Nitrokey/nitrokey-3a-nfc-lpc55-hardware/README.md

# Nitrokey 3A NFC Hardware

The hardware files of [Nitrokey 3A NFC](https://shop.nitrokey.com/shop/nk3an-nitrokey-3a-nfc-147).
The firmware is [here](https://github.com/Nitrokey/nitrokey-3-firmware).
