Nitrokey/nitrokey-3a-nfc-lpc55-hardware/production-data/nk3an133-gaia-BOM.xlsx

BOM Version 3 | NK3AN133 – Gaia | 2026-04-23
Component | Description | Part | References | Value | Footprint | Quantity Per PCB | MPN | Manufacturer | Alternative | URL
1 | C0G cap, pref 2%, max 5% | C | C20 C21 CY1 | 8pF | C_0402_1005Metric | 3
2 | C0G cap | C | C16 | 47pF | C_0402_1005Metric | 1
3 | X5R or X7R, 10V | C | C2 C14 C15 | 100n | C_0402_1005Metric | 3
4 | X5R 10V | C | C1 C3 C4 | 22u | C_0603_1608Metric | 3 | C1608X5R1A226M080AC | TDK Corporation
5 | X5R or X7R, 10V | C | C13 C17 | 10uF | C_0402_1005Metric | 2 |  |  | Taiyo Yuden LDK105CBJ106MVLF
6 | C0G cap, pref. 2%, max 5% | C | CX1 | 100pF | C_0402_1005Metric | 1
7 | C0G cap | C | C5 | 20pF | C_0402_1005Metric | 1
8 | Resistor 1% | R | R2 | 1k | R_0402_1005Metric | 1
9 | TVS Diode | tvs diode | D2 | TPD4S012DRYR | UFDFN-6_1.45x1mm | 1 | TPD4S012DRYR | Texas Instruments
10 | SPI flash IC | spi flash | F1 | GD25Q16EEIGR | FLASH_2x3_USON8 | 1 | GD25Q16EEIGR | GigaDevice Semiconductor (HK) Limited
11 | FPC connector 1x4 0.5mm | fpc conn | J2 | Conn_01x04 | FPC_4_0.5-THD0509-04CL-GF | 1 | THD0509-04CL-GF | THD |  | https://www.lcsc.com/product-detail/C283133.html
12 | Inductor | L | L2 | 4u7H | L_0603_1608Metric | 1 | MLF1608A4R7KTA00 | TDK Corporation
13 | RGB LED, red/green/blue/anode | LED_RGBA | L1 | LED_RGBA | RGB_LED_606 | 1 | 150066M153000 | Würth
14 | NFC power harvesting IC | FM11NC08 | N1 | FM11NC08 | MLPD3X3 | 1 | FM11NC08 | Shanghai Fudan Microelectronics Group
15 | USB-A male plug | USB_A_Plug | J1 | USB_A_Plug | USB-A-PLUG | 1 | 480372200 | Molex
16 | Resistor 1% | R | R1 | 180R | R_0402_1005Metric | 1
17 | Resistor 1% | R | R3 R4 R6 | 4.7k | R_0402_1005Metric | 3
18 | 3.3V LDO | TLV742p | T1 | TLV742p | Texas_X2SON-4_1x1mm_P0.65mm | 1 | TLV74233PDQNR | Texas Instruments | Diodes AP7340-33FS4-7
19 | LPC55 microcontroller | LPC55S69JEV98K | U1 | LPC55S69JEV98K | BGA98C50P13X13_700X700X97N | 1 | LPC55S69JEV98K | NXP USA Inc.
20 | Proximity sensor | TTP233D-HA6 | U2 | TTP233 | SOT-23-6 | 1 | TTP233D-HA6 | Tontek Design Tech
21 | Secure element | SE050 | U3 | SE050 | UQFN-20-1EP_3x3mm_P0.4mm_EP1.85x1.85mm | 1 | SE050C1HQ1/Z01SCZ | NXP | SE050C2HQ1/Z01SCZ
22 | Two pin crystal | Crystal | Y1 | XRCGB16M000FXN01R0 | Crystal-2mmx1.6mm | 1 | XRCGB16M000FXN01R0 | Murata
23 | Bidirectional transient-voltage-suppression diode | D_TVS | Z1 | GG040205100N2P | D_0402_1005Metric | 1 | GG040205100N2P | AVX Corporation
