Nitrokey/nitrokey-3a-nfc-lpc55-hardware/NK3AN-lpc55-v1.pdf

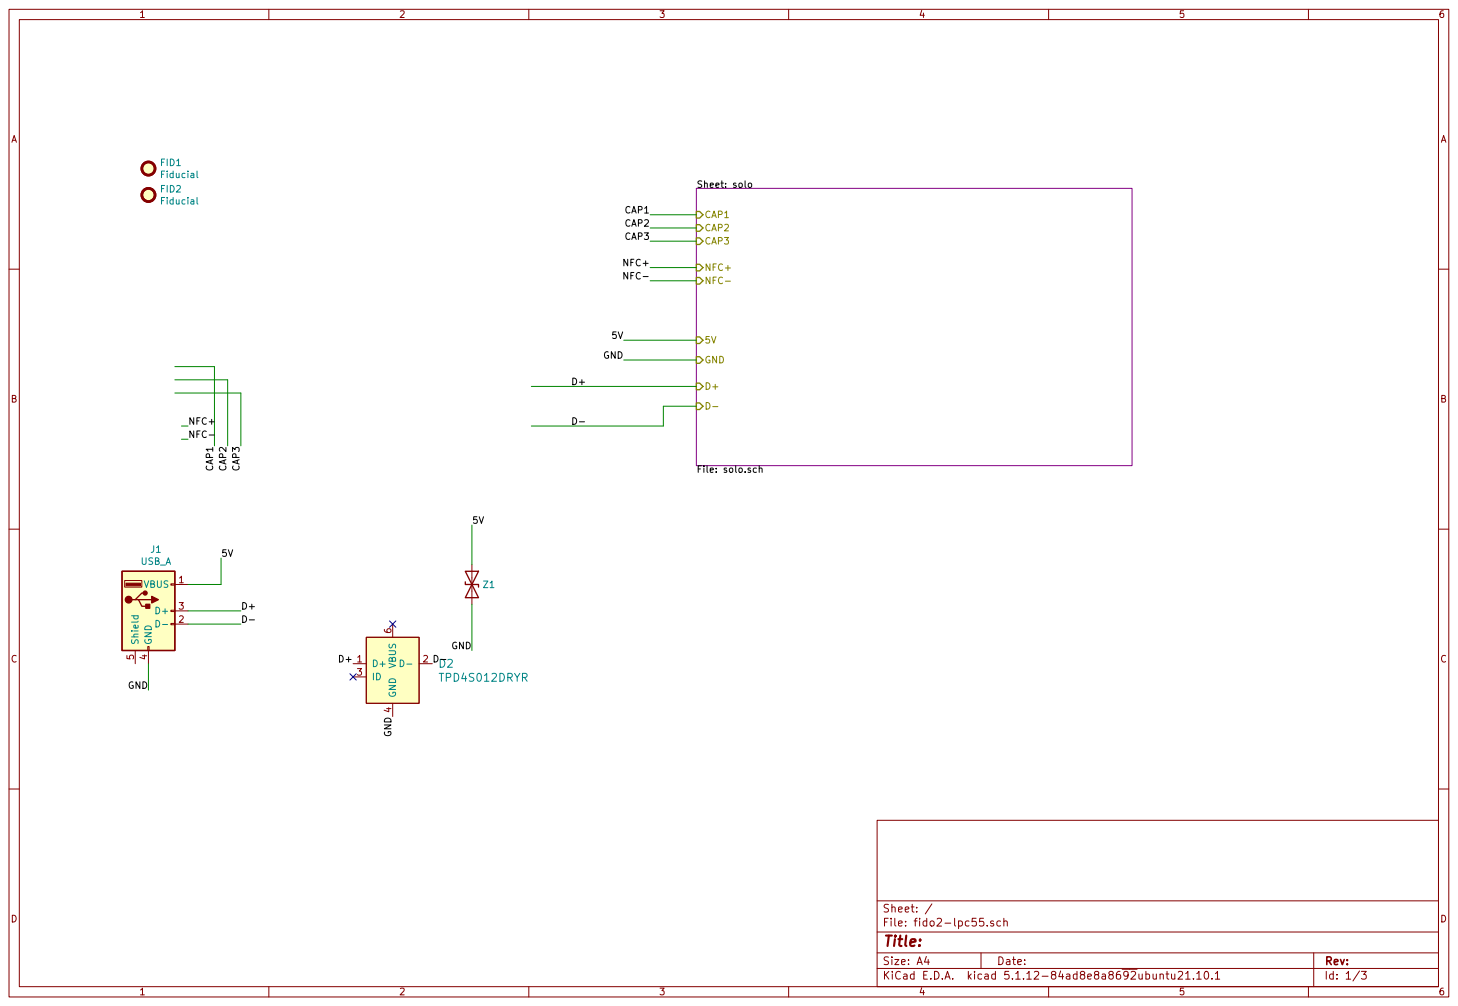
[picture p1: page 1]

Sheet: solo File: solo.sch

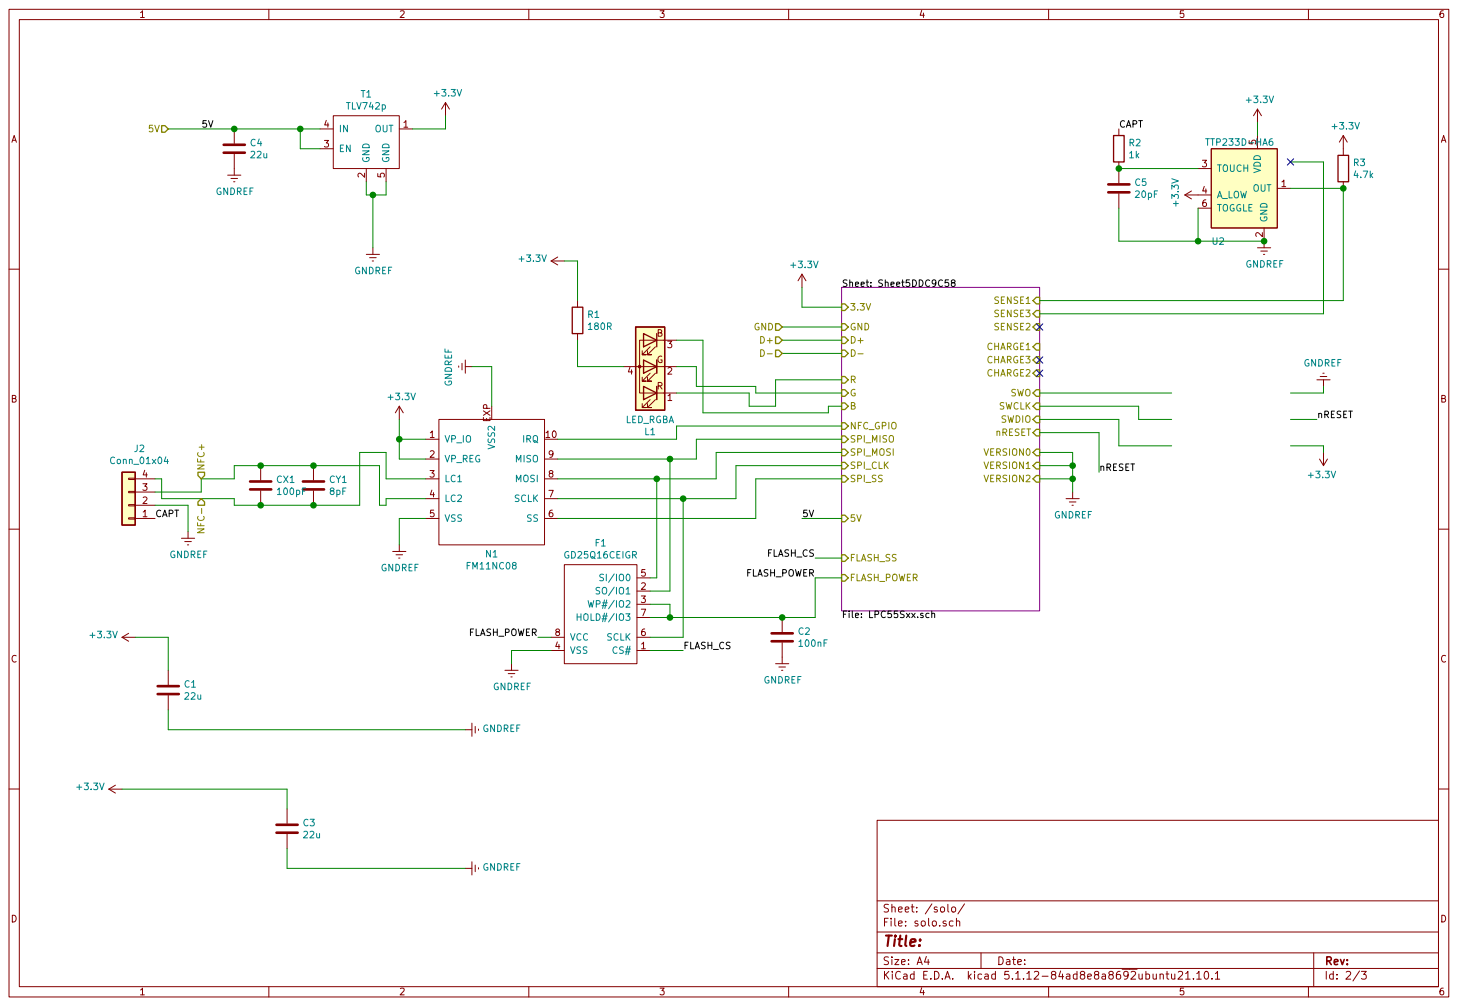
[picture p2: page 2]

Id: 2/3 Title: File: solo.sch Sheet: /solo/

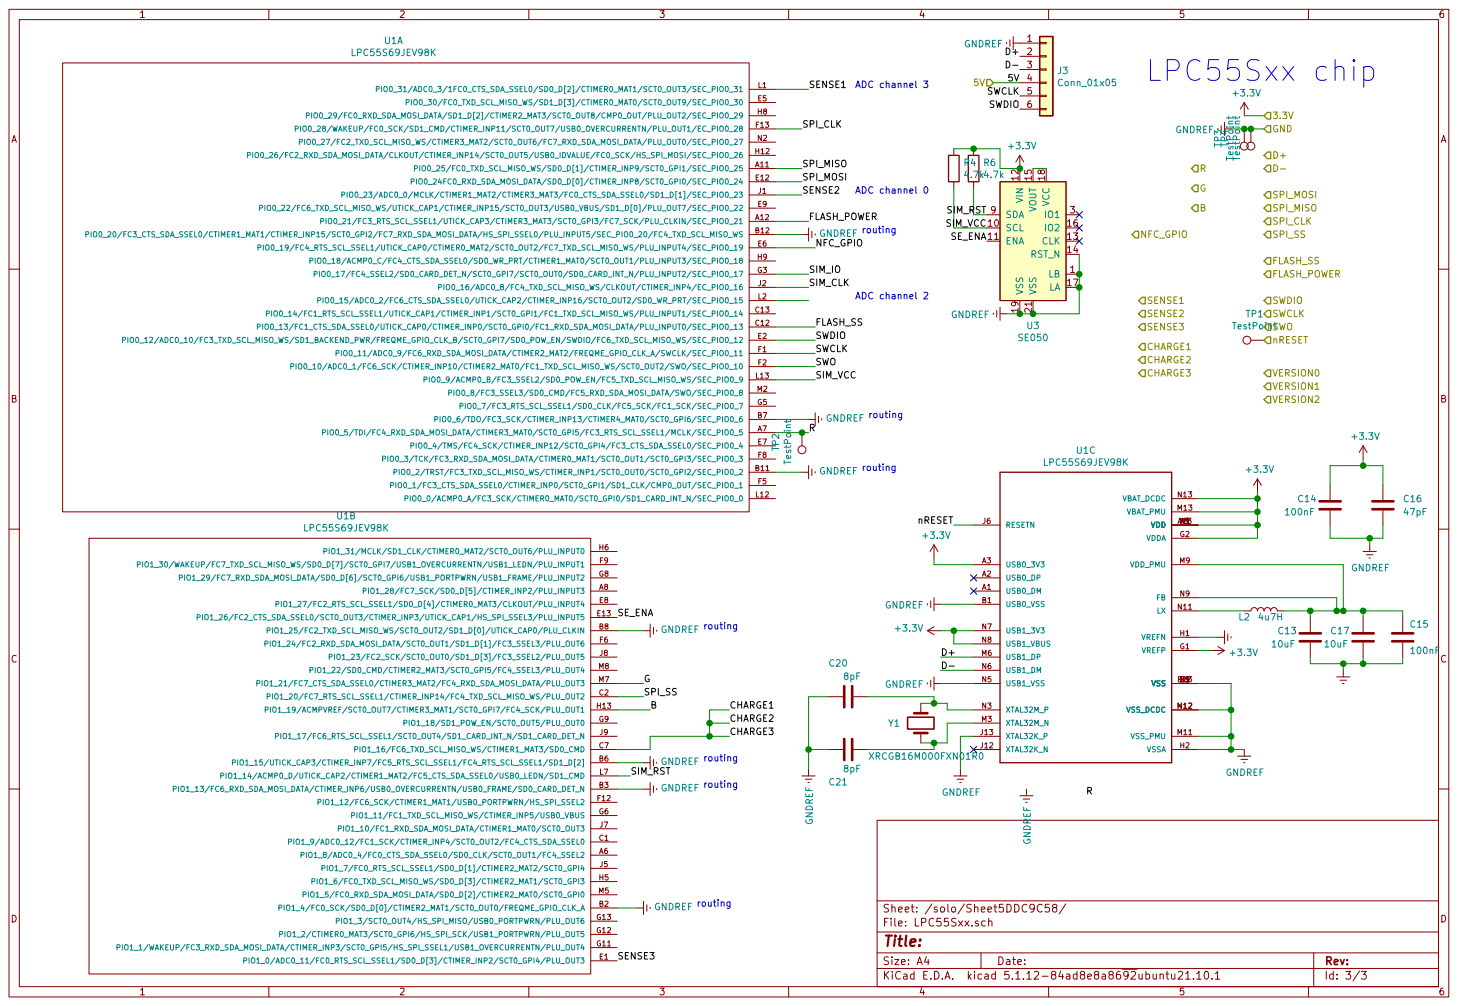
[picture p3: page 3]

ADC channel 0 ADC channel 3

Id: 3/3 Title: File: LPC55Sxx.sch Sheet: /solo/Sheet5DDC9C58/
