Nitrokey/nitrokey-3a-nfc-lpc55-hardware/fido2-lpc55.kicad_pcb

## KiCad design fido2-lpc55.kicad_pcb (2026-04-24)

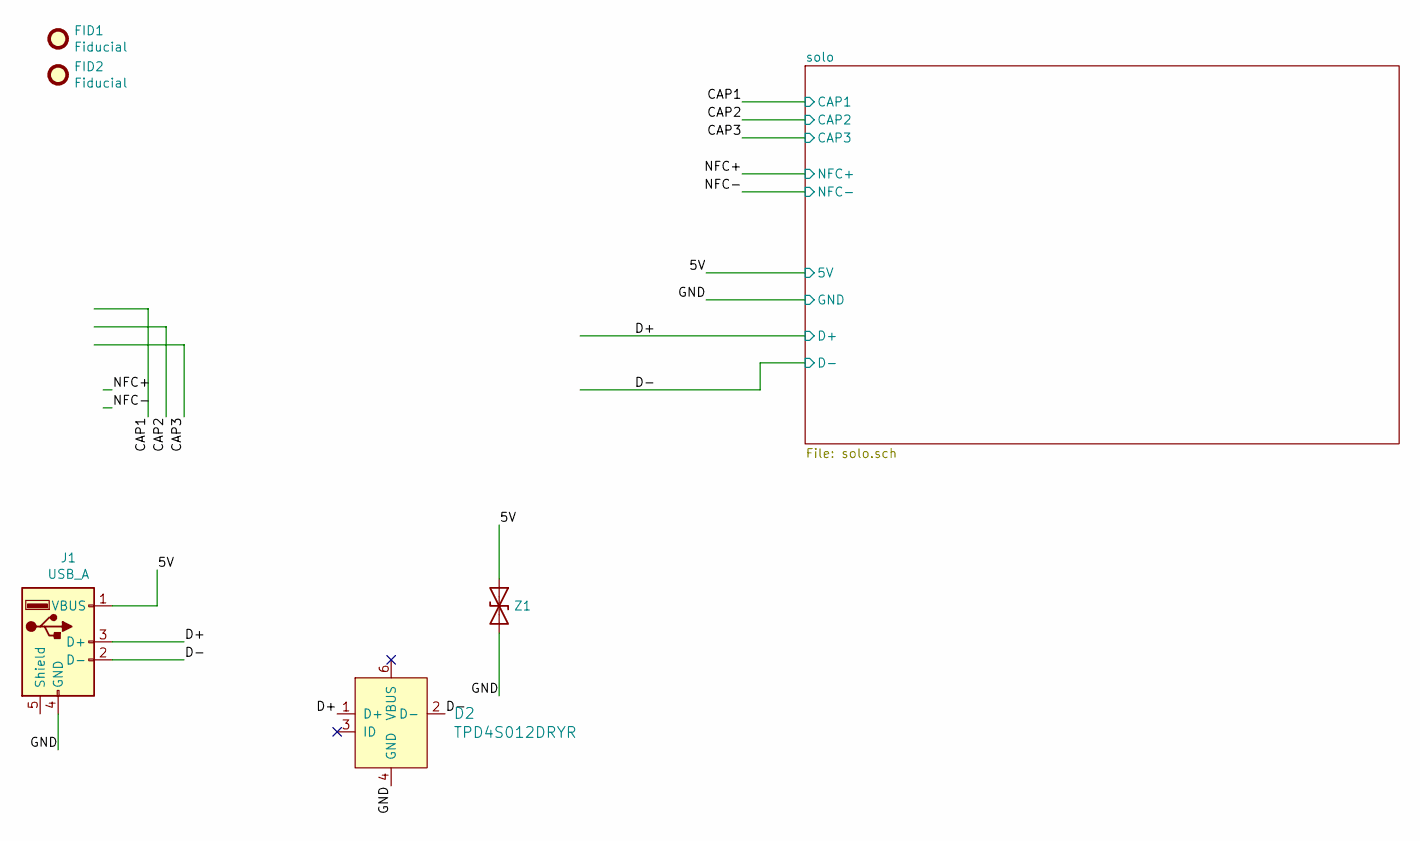
[picture p4: schematic fido2-lpc55.sch]

Parts:
D2: TPD4S012DRYR; UFDFN-6_1.45x1mm; MPN TPD4S012DRYR; Digi-Key_PN 296-24244-1-ND
FID1, FID2: Fiducial; Fiducial_0.5mm_Mask1mm
J1: USB_A; USB-A-PLUG
Z1: GG040205100N2P; R_0402_1005Metric; MPN GG040205100N2P

Connections:
/5V: J1.1 (VBUS), Z1.1 (A1); also elsewhere on the board
/D+: D2.1 (D+), J1.3 (D+); also elsewhere on the board
/D-: D2.2 (D-), J1.2 (D-); also elsewhere on the board
GNDREF: D2.4 (GND), J1.4 (GND), Z1.2 (A2); also elsewhere on the board

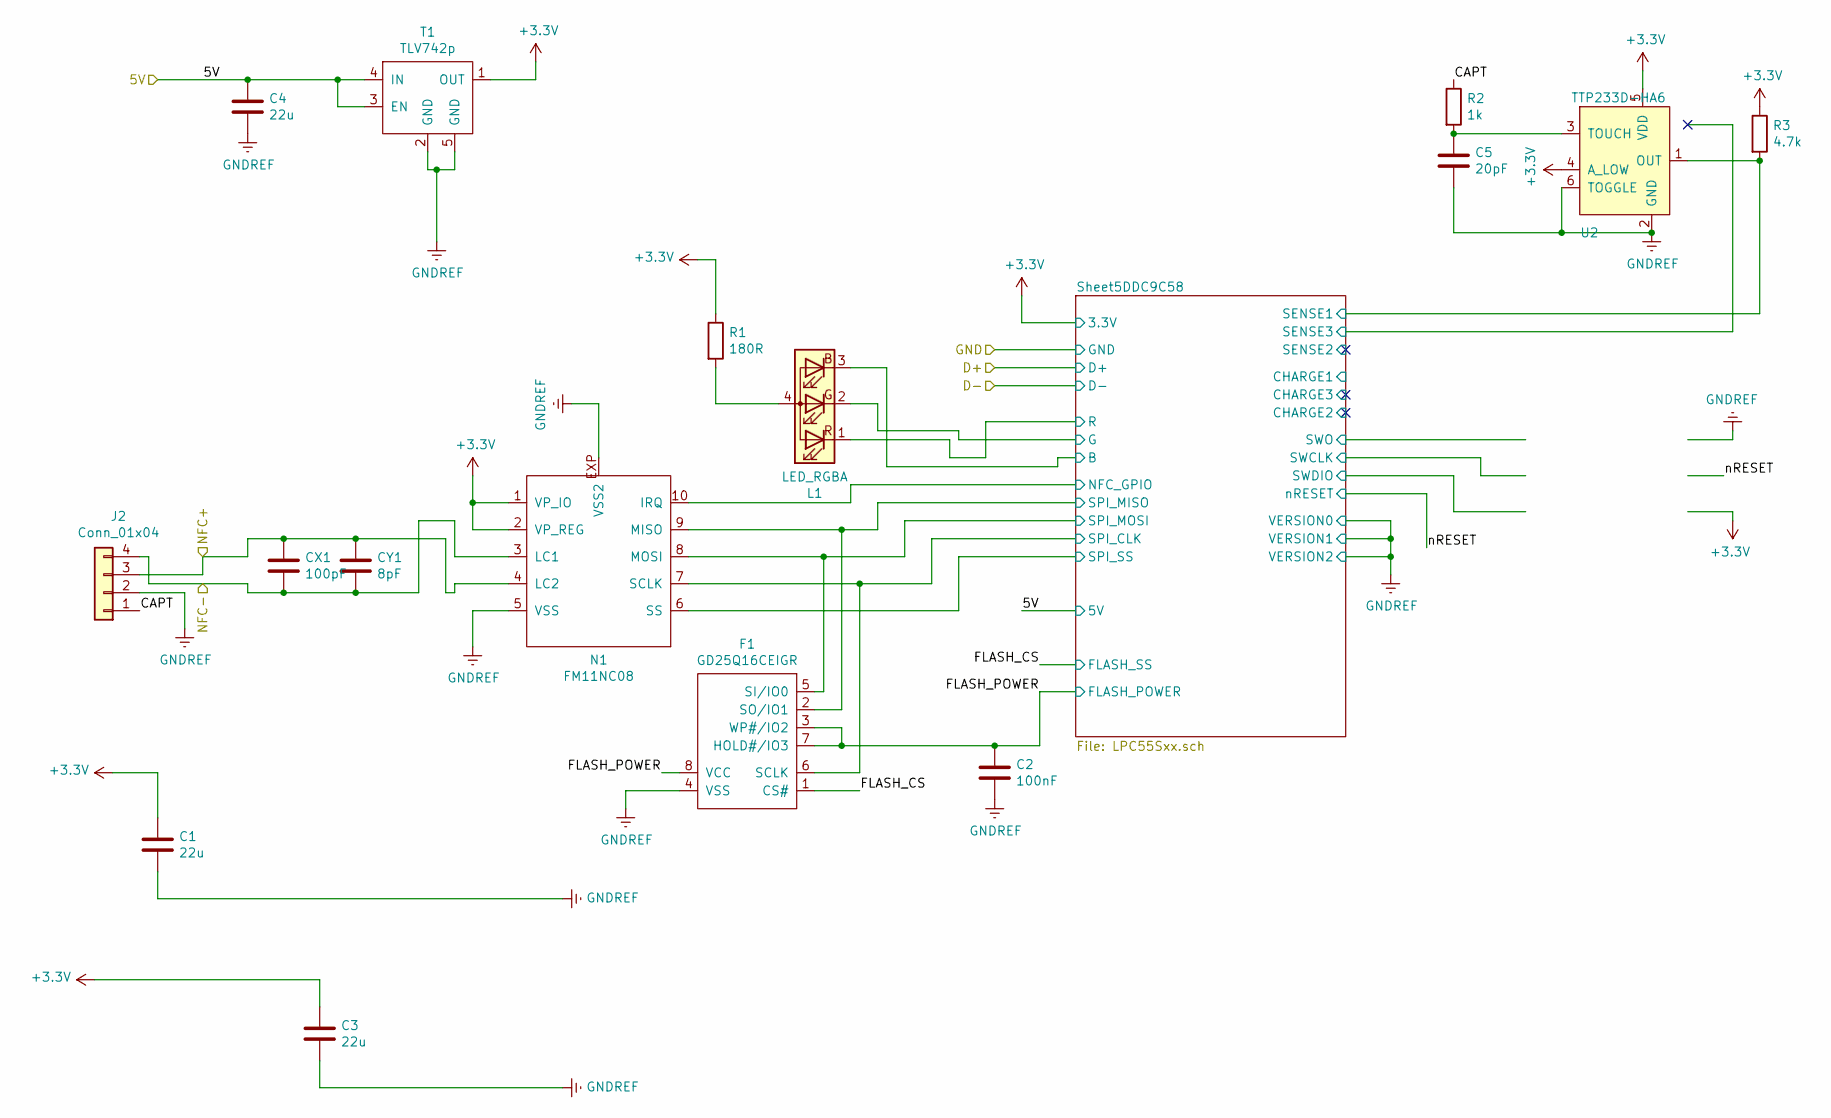
[picture p5: schematic solo.sch]

Parts:
C1, C3, C4: 22u; C_0603_1608Metric
C2: 100nF; C_0402_1005Metric
C5: 20pF; C_0402_1005Metric
CX1: 100pF; C_0402_1005Metric
CY1: 8pF; C_0402_1005Metric
F1: GD25Q16CEIGR; FLASH_2x3_USON8; MPN GD25Q16CEIGR
J2: Conn_01x04; FPC_4_0.5-THD0509-04CL-GF
L1: LED_RGBA; RGB_LED_606; MPN EAST1616RGBB4
N1: FM11NC08; DFN-10-1EP_3x3mm_P0.5mm_EP1.55x2.48mm; MPN FM11NC08
R1: 180R; R_0402_1005Metric
R2: 1k; R_0402_1005Metric
R3: 4.7k; R_0402_1005Metric
T1: TLV742p; Texas_X2SON-4_1x1mm_P0.65mm; MPN TLV74233PDQNR
U2: TTP233D-HA6; TSOT-23-6

Connections:
+3V3: C1.1, C3.1, N1.1 (VP_IO), N1.2 (VP_REG), R1.1, R3.1, T1.1 (OUT), U2.4 (A_LOW), U2.5 (VDD); also elsewhere on the board
/5V: C4.1, T1.3 (EN), T1.4 (IN); also elsewhere on the board
/NFC+: CX1.1, CY1.1, J2.3, N1.4 (LC2)
/NFC-: CX1.2, CY1.2, J2.4, N1.3 (LC1)
/solo/CAPT: J2.1, R2.1
/solo/FLASH_CS: F1.1 (CS#); also elsewhere on the board
/solo/FLASH_POWER: C2.1, F1.3 (WP#/IO2), F1.7 (HOLD#/IO3), F1.8 (VCC); also elsewhere on the board
/solo/Sheet5DDC9C58/B: L1.3 (BK); also elsewhere on the board
/solo/Sheet5DDC9C58/G: L1.2 (GK); also elsewhere on the board
/solo/Sheet5DDC9C58/NFC_GPIO: N1.10 (IRQ); also elsewhere on the board
/solo/Sheet5DDC9C58/R: L1.1 (RK); also elsewhere on the board
/solo/Sheet5DDC9C58/SENSE1: R3.2, U2.1 (OUT); also elsewhere on the board
/solo/Sheet5DDC9C58/SPI_CLK: F1.6 (SCLK), N1.7 (SCLK); also elsewhere on the board
/solo/Sheet5DDC9C58/SPI_MISO: F1.2 (SO/IO1), N1.9 (MISO); also elsewhere on the board
/solo/Sheet5DDC9C58/SPI_MOSI: F1.5 (SI/IO0), N1.8 (MOSI); also elsewhere on the board
/solo/Sheet5DDC9C58/SPI_SS: N1.6 (SS); also elsewhere on the board
GNDREF: C1.2, C2.2, C3.2, C4.2, C5.2, F1.4 (VSS), J2.2, N1.5 (VSS), N1.EXP (VSS2), T1.2 (GND), T1.5 (GND), U2.2 (GND), U2.6 (TOGGLE); also elsewhere on the board
unnamed: C5.1, R2.2, U2.3 (TOUCH)
unnamed: L1.4 (A), R1.2

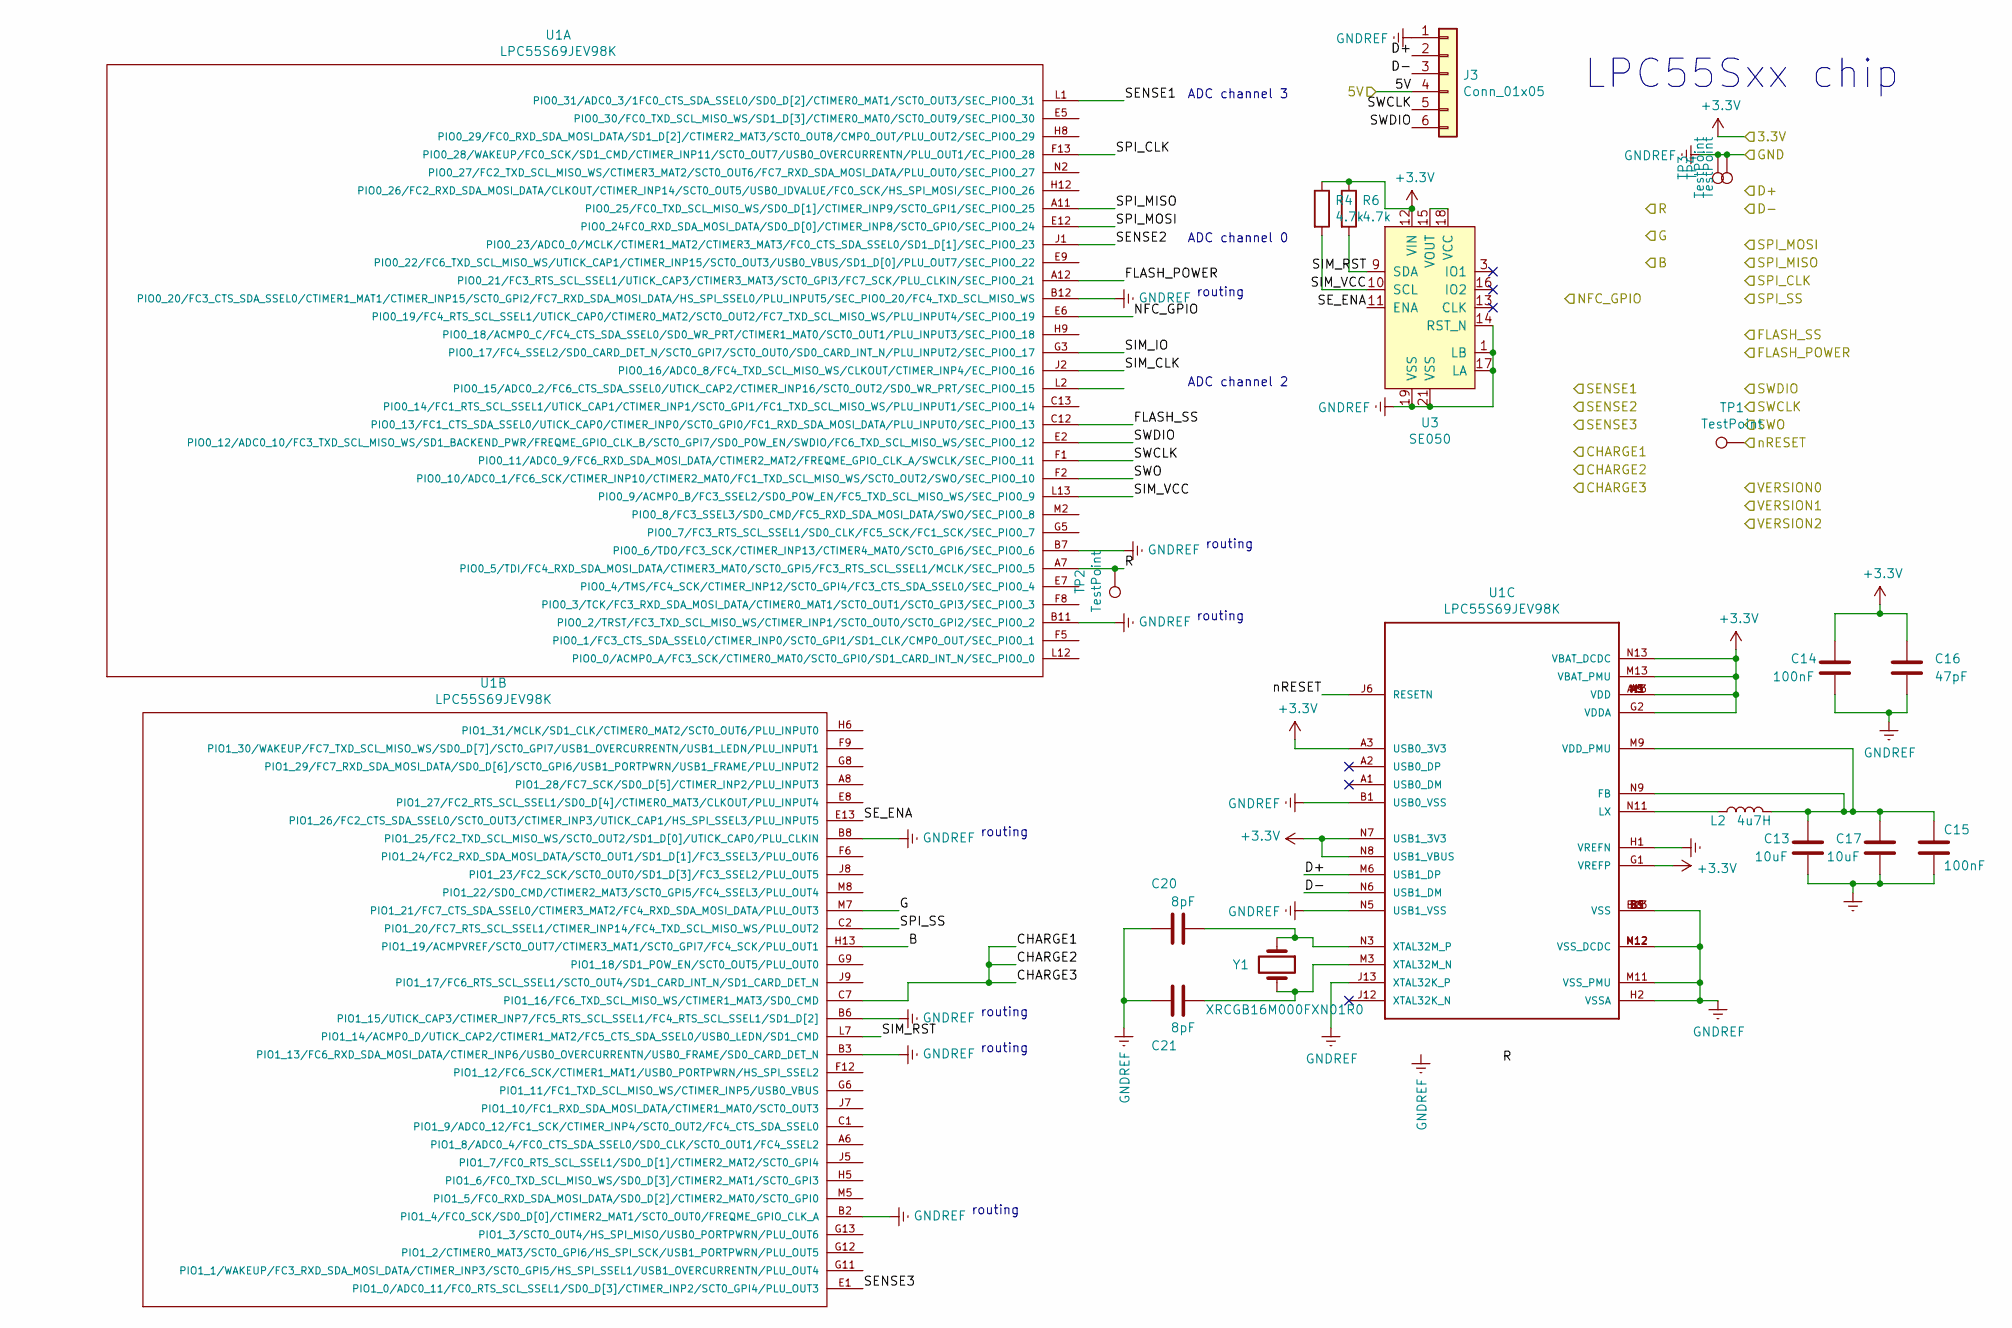
[picture p6: schematic LPC55Sxx.sch]

Parts:
C13, C17: 10uF; C_0402_1005Metric
C14, C15: 100nF; C_0402_1005Metric
C16: 47pF; C_0402_1005Metric
C20, C21: 8pF; C_0402_1005Metric
J3: Conn_01x05; nitro_programming_header
L2: 4u7H; L_0603_1608Metric; MPN MLF1608A4R7KTA00
R4, R6: 4.7k; R_0402_1005Metric
TP1, TP2, TP3, TP4: TestPoint; TestPoint_Pad_1.5x1.5mm
U1: LPC55S69JEV98K; BGA98C50P13X13_700X700X97N; MPN LPC55S69JEV98K
U3: SE050; UQFN-20-1EP_3x3mm_P0.4mm_EP1.85x1.85mm
Y1: XRCGB16M000FXN01R0; Crystal-2mmx1.6mm; MPN XRCGB16M000FXN01R0

Connections:
+3V3: C14.1, C16.1, R4.1, R6.1, U1.A3 (USB0_3V3), U1.A5 (VDD), U1.A9 (VDD), U1.A13 (VDD), U1.G1 (VREFP), U1.G2 (VDDA), U1.M1 (VDD), U1.M13 (VBAT_PMU), U1.N7 (USB1_3V3), U1.N8 (USB1_VBUS), U1.N13 (VBAT_DCDC), U3.12 (VIN); also elsewhere on the board
/5V: J3.4; also elsewhere on the board
/D+: J3.2, U1.M6 (USB1_DP); also elsewhere on the board
/D-: J3.3, U1.N6 (USB1_DM); also elsewhere on the board
/solo/FLASH_CS: U1.C12 (PIO0_13/FC1_CTS_SDA_SSEL0/UTICK_CAP0/CT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); also elsewhere on the board
/solo/FLASH_POWER: U1.A12 (PIO0_21/FC3_RTS_SCL_SSEL1/UTICK_CAP3/CT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); also elsewhere on the board
/solo/Sheet5DDC9C58/B: U1.H13 (PIO1_19/ACMPVREF/SCT0_OUT7/CTIMER3_MAT1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); also elsewhere on the board
/solo/Sheet5DDC9C58/CHARGE1: U1.C7 (PIO1_16/FC6_TXD_SCL_MISO_WS/CTIMER1_MAT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)
/solo/Sheet5DDC9C58/G: U1.M7 (PIO1_21/FC7_CTS_SDA_SSEL0/CTIMER3_MAT2/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); also elsewhere on the board
/solo/Sheet5DDC9C58/NFC_GPIO: U1.E6 (PIO0_19/FC4_RTS_SCL_SSEL1/UTICK_CAP0/CT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); also elsewhere on the board
/solo/Sheet5DDC9C58/R: TP2.1, U1.A7 (PIO0_5/TDI/FC4_RXD_SDA_MOSI_DATA/CTIMER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); also elsewhere on the board
/solo/Sheet5DDC9C58/SENSE1: U1.L1 (PIO0_31/ADC0_3/1FC0_CTS_SDA_SSEL0/SD0_D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); also elsewhere on the board
/solo/Sheet5DDC9C58/SENSE2: U1.J1 (PIO0_23/ADC0_0/MCLK/CTIMER1_MAT2/CTIMER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)
/solo/Sheet5DDC9C58/SENSE3: U1.E1 (PIO1_0/ADC0_11/FC0_RTS_SCL_SSEL1/SD0_D[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)
/solo/Sheet5DDC9C58/SE_ENA: U1.E13 (PIO1_26/FC2_CTS_SDA_SSEL0/SCT0_OUT3/CTI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), U3.11 (ENA)
/solo/Sheet5DDC9C58/SIM_CLK: U1.J2 (PIO0_16/ADC0_8/FC4_TXD_SCL_MISO_WS/CLKO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)
/solo/Sheet5DDC9C58/SIM_IO: U1.G3 (PIO0_17/FC4_SSEL2/SD0_CARD_DET_N/SCT0_G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)
/solo/Sheet5DDC9C58/SIM_RST: R6.2, U1.L7 (PIO1_14/ACMP0_D/UTICK_CAP2/CTIMER1_MAT2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), U3.9 (SDA)
/solo/Sheet5DDC9C58/SIM_VCC: R4.2, U1.L13 (PIO0_9/ACMP0_B/FC3_SSEL2/SD0_POW_EN/FC5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), U3.10 (SCL)
/solo/Sheet5DDC9C58/SPI_CLK: U1.F13 (PIO0_28/WAKEUP/FC0_SCK/SD1_CMD/CTIMER_I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); also elsewhere on the board
/solo/Sheet5DDC9C58/SPI_MISO: U1.A11 (PIO0_25/FC0_TXD_SCL_MISO_WS/SD0_D[1]/CT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); also elsewhere on the board
/solo/Sheet5DDC9C58/SPI_MOSI: U1.E12 (PIO0_24FC0_RXD_SDA_MOSI_DATA/SD0_D[0]/C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); also elsewhere on the board
/solo/Sheet5DDC9C58/SPI_SS: U1.C2 (PIO1_20/FC7_RTS_SCL_SSEL1/CTIMER_INP14/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); also elsewhere on the board
/solo/Sheet5DDC9C58/SWCLK: J3.5, U1.F1 (PIO0_11/ADC0_9/FC6_RXD_SDA_MOSI_DATA/CT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)
/solo/Sheet5DDC9C58/SWDIO: J3.6, U1.E2 (PIO0_12/ADC0_10/FC3_TXD_SCL_MISO_WS/SD1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)
/solo/Sheet5DDC9C58/SWO: U1.F2 (PIO0_10/ADC0_1/FC6_SCK/CTIMER_INP10/CTI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)
/solo/nRESET: TP1.1, U1.J6 (RESETN)
GNDREF: C13.2, C14.2, C15.2, C16.2, C17.2, C20.1, C21.1, J3.1, TP3.1, TP4.1, U1.B1 (USB0_VSS), U1.B2 (PIO1_4/FC0_SCK/SD0_D[0]/CTIMER2_MAT1/SC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), U1.B3 (PIO1_13/FC6_RXD_SDA_MOSI_DATA/CTIMER_IN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), U1.B5 (VSS), U1.B6 (PIO1_15/UTICK_CAP3/CTIMER_INP7/FC5_RTS_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), U1.B7 (PIO0_6/TDO/FC3_SCK/CTIMER_INP13/CTIMER4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), U1.B8 (PIO1_25/FC2_TXD_SCL_MISO_WS/SCT0_OUT2/S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), U1.B9 (VSS), U1.B11 (PIO0_2/TRST/FC3_TXD_SCL_MISO_WS/CTIMER_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), U1.B12 (PIO0_20/FC3_CTS_SDA_SSEL0/CTIMER1_MAT1/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), U1.B13 (VSS), U1.H1 (VREFN), U1.H2 (VSSA), U1.J13 (XTAL32K_P), U1.M11 (VSS_PMU), U1.M12 (VSS_DCDC), U1.N1 (VSS), U1.N5 (USB1_VSS), U1.N12 (VSS_DCDC), U3.1 (LB), U3.14 (RST_N), U3.17 (LA), U3.19 (VSS), U3.21 (VSS); also elsewhere on the board
unnamed: C13.1, C15.1, C17.1, L2.2, U1.M9 (VDD_PMU), U1.N9 (FB)
unnamed: C20.2, U1.N3 (XTAL32M_P), Y1.1
unnamed: C21.2, U1.M3 (XTAL32M_N), Y1.2
unnamed: L2.1, U1.N11 (LX)
unnamed: U3.15 (VOUT), U3.18 (VCC)

Notes on the sheet:
LPC55Sxx chip
ADC channel 2
ADC channel 0
routing
ADC channel 3

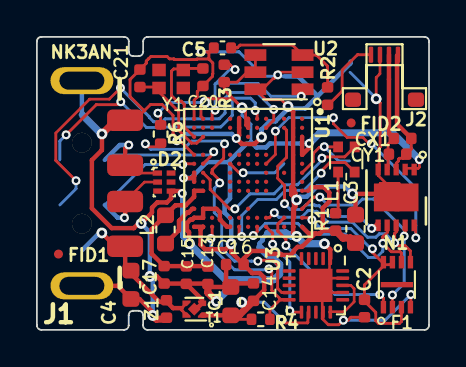
[picture p7: board fido2-lpc55.kicad_pcb from above]

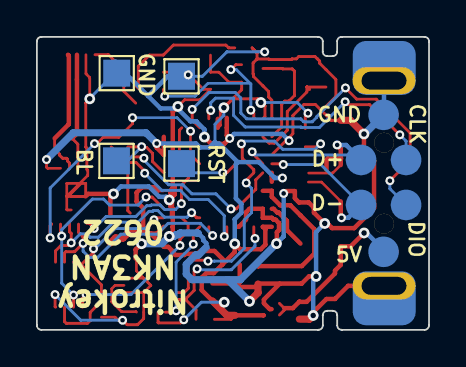
[picture p8: board fido2-lpc55.kicad_pcb from below]

Board: 2 copper layers, 21.8 x 16.3 mm, 39 parts (5 on the bottom side), 32 nets.
