Nitrokey/nitrokey-3a-nfc-lpc55-hardware/(threads)

Thread 1 (2023-02-14):

Which SE050 part number is used?

saper, 2023-02-14:
[USB Armory Mk2](https://usbarmory.github.io/BOM/usbarmory-mark-two.html) says they use SE050C1HQ1/Z01SCZ - which part number is used here?

There are some differences between SE050B/C/E/F variants, for example https://www.nxp.com/docs/en/application-note/AN12436.pdf

saper, 2023-02-14:
Sorry, found it in BOM https://github.com/Nitrokey/nitrokey-3a-nfc-lpc55-hardware/blob/9aac84400ee7698cafe075cd3c4fa9d7ec2b7d57/production-data/nk3a-nfc_bom.xlsx it's SE050C1HQ1/Z01SCZ

sorry for noise!

Closed 2023-02-14.
